cluc164/quad/README.md

# Quadcopter Build

I saw a video on how quadcopters worked and it inspired me to really learn the science behind quadcopters, how they're constructed, and to try to build my own! The first step was to essentially read as much as possible: watching YouTube videos, reading research papers, relearning physics...

I wanted a challenge, but I also didn't want to be completely in over my head. Luckily, people have built quadcopters before and I was able to find a guy on YouTube who had built one and provided both source code and a schematic! But I didn't want to be boring and just yoink someone else's code for a project like this without understanding it... So I yoinked his schematic, bought all the parts, and began learning how to program flight control software. 

## Transmitter

For some reason, I figured that starting with the thing that allowed me to actually control the quadcopter was a good idea! I bought an FS-T6 transmitter/receiver combo, and from reading the manual I knew that controls were linked with certain channels; e.g. the right stick's x-axis (roll) corresponded with channel 1 on the receiver. I connected channels 1-4 to the Arduino's I/O pins 8-11 via jumper cables, and set to work.

At first, I didn't understand how the state of the transmitter was communicated at all, so I just tried to set the pins that I had connected to the receiver to digital input, and from there simply digitalRead() the values; easy, right? Well, not really. 

Turns out we've thought up some really, really clever ways to communicate information. Transmitters and receivers for RC control make use of a concept called Pulse-Width Modulation (PWM) that allows the transmitter to communicate data about its state using digital pulses of a certain duration. Each of these signals is transmitted via a single channel as discussed above. Reading the length of these pulses gives us the information about the position of the control. These will be measured in microseconds, so for example; 1000us pulse length = stick all the way to the left, 1500us = stick in the middle, 2000us = stick right.

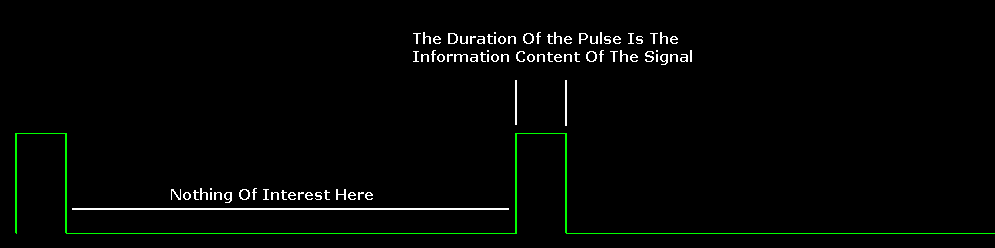
[picture p1: pictures/PulseDuration.PNG]


So, calling digitalRead() on the pin was wrong, and I somehow needed to measure the pulse length of four signals... I googled it and found [this](https://ryanboland.com/blog/reading-rc-receiver-values), which told me I needed to find a way to listen to state changes on each I/O pin corresponding to a channel from the receiver. Arduino provides an `attachInterrupt()` method, which listens to the state of a pin and triggers a callback based on that; however, it's only implemented for pins 2 & 3. I needed four channels, which meant 4 pins. More Google and I found resource (1), which showed me how to interact directly with the Atmega328p microcontroller on the Arduino board.

 



By setting the PCICR (pin change interrupt control register) within the Atmega to 0b00000001, it allows external interrupts on a range of registers (PCINT0-PCINT7). Of interest to us are PCINT0-PCINT3, which are the registers corresponding to digital pins 8-11. To define which pins trigger an interrupt, we set PCMSK0 to 0x0F, which enables interrupts for state changes on registers PCINT0-PCINT3. Now, whenever the state of one of these pins is changed from high to low or vice versa, the microcontroller will trigger a software response called an Interrupt Service Routine (ISR) where I can run logic and do something useful, like read the state of a register! What I have at this point is a program that listens for state changes on I/O pins 8-11 and when that occurs, a function called `ISR(PCINT0_vect) {}` is called.  

We want to measure the time from when the signal goes high to when it goes back low. First, I started with a single channel: when the ISR is triggered, read the least significant bit of PINB (more info in resource (2); address that allows direct read access to PORTB, which is the register corresponding to pin 8). If this bit is 1, then the state is high and we know the state just went from low to high (rising edge) so we can record the current time. Now, we just wait until the state falls from high to low, and record the difference between the time at that point and the time recorded at the rising edge. This gives us the pulse length for a single channel.

Excited that I'd correctly obtained data from the transmitter, I copy and pasted the code and edited it to look at the data from all 4 channels and rather than getting nice, clean numbers between 1000 and 2000, I got this data where each column corresponds to a channel's input. 

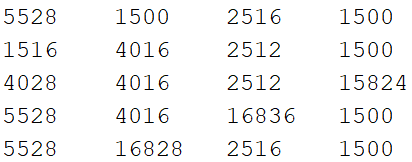
[picture p2: pictures/unstable.png]
 

Looking into this, you can notice that some columns do actually get nice data once and awhile, but it's inconsistent. I realized that in some cases, it's entirely possible that one pin's interrupt could occur during the time in which another pin has already been high or low for a certain amount of time. Blindly recording the time works for a single channel when we can guarantee the ISR is triggered on a rising or falling edge; this will not work when there are 4 pins that can each individually trigger the ISR at different times. Essentially, the time was being measured incorrectly because pin state changes were occurring at different times with no fail-safes to ensure we were properly measuring one pulse or another. To fix this, simply add in a state check that verifies whether or not we have already detected the rising edge for a specific pulse.  This ensures that only the rising/falling edge is detected for each channel, and the pulse lengths are recorded properly. After adding in these checks for each channel, the data columns are much nicer looking, albeit minutely noisy. 

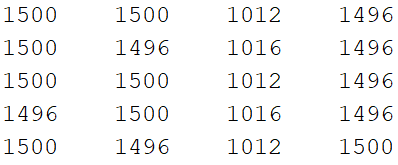
[picture p3: pictures/stable.png]


At this point, I have stable data that corresponds to the position of each control stick on the transmitter. All I will do is absolutely ensure that the values are within a certain range via mapping.

## Motors

For my quadcopter, I bought 1000KV brushless motors with 30A electronic speed controllers (ESCs). With an 11.1V battery, this meant my motors could spin at up to roughly 11,000 RPM... which is pretty fast! The motor speed is controlled by pulses from the ESC, which are then in turn controlled by a PWM signal from an input pin.

There seemed to be a couple ways I could do this; use the provided Servo library and just send it the output signal, or actually create the pulses myself. The first option was easiest just to get it actually working so I did that, and had a spinning motor up and running within about 10 minutes. The problem is that this required me to write to the motors sequentially; I couldn't trigger all 4 motors at exactly the same moment, I'd have to write to one, then the next... That's not exactly desirable, so I started to look into using port manipulation to send all four motor pulses at the same time.

Now that I know how to read/write from registers representing I/O pins, it's much easier to wrap my head around what I needed to do, and I started by drawing a picture. Essentially I needed to reverse what I'd done when reading in the PWM signal from the transmitter: send out a digital signal that's high for a certain duration of time to each pin corresponding to a motor. To accomplish this I only really required three things: a pulse length (which I get from the signal from the transmitter's throttle stick), a start time, and a connection point (I connected a single motor to pin 4, which is PORTD register 4).

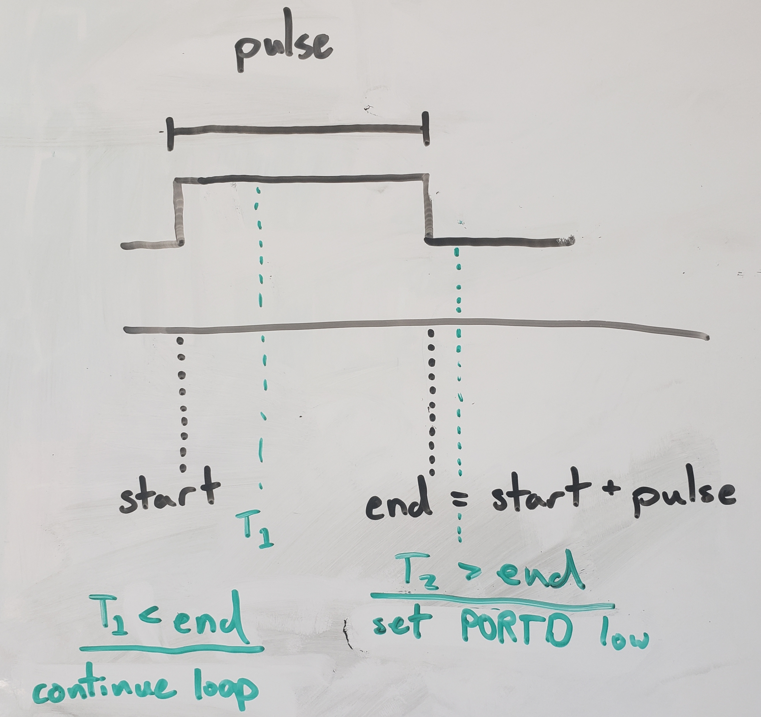
[picture p4: pictures/motor_pulse.jpg]


All I did was set PORTD4 high and then enter into a loop. Inside this loop, I checked the current time against the start time added to the pulse length; if the current time is less than that value, the pulse should remain high. However, as soon as the current time is equal to or greater than the saved end time, we should set the pulse to low, which allows the loop to exit. This is scalable to all four motor outputs, as four if-statements checking time within a loop is not costly at all, and allows us to relay the PWM signal from the transmitter into the motors.

## Frame

So, I forgot to take pictures toward the beginning of the process. But basically, I bought a DJI F450 frame and needed to solder things together and find a way to hold the battery, gyro, controller, and receiver. 

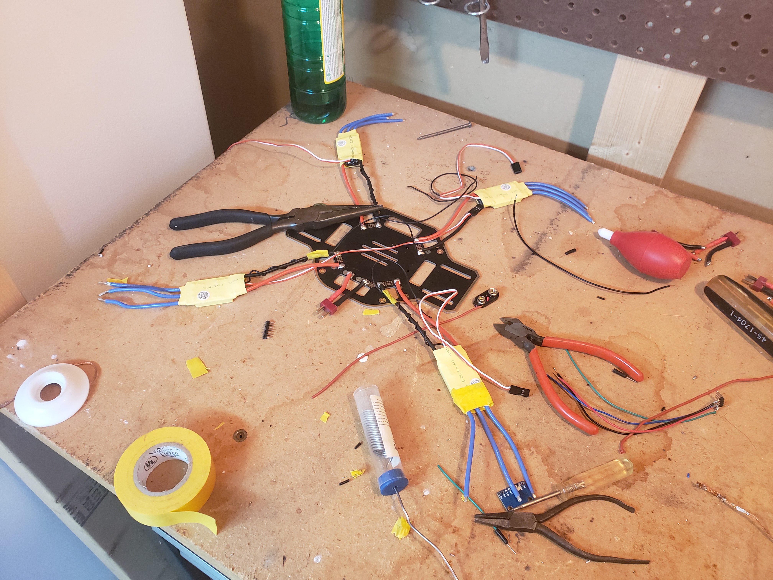
[picture p5: pictures/frame.jpg]


I soldered the ESCs to the frame directly, and also wired the digital ground onto the frame. I also made an LED with a resistor that is plugged into the controller for status indication. Additionally, to power the flight controller and measure the battery voltage, I made a voltage divider and a 2-pin power connection with a diode as follows (don't worry, I isolated everything with electrical tape after I took this picture, heat-shrink is my next purchase):

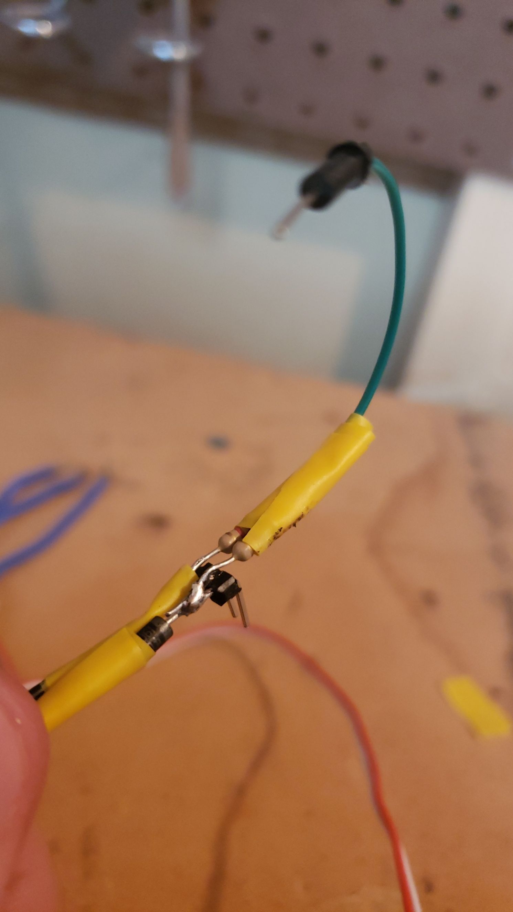
[picture p6: pictures/power.jpg]


After I did this, I attached the ESC and motor connections to bullet connectors, checked all the pins and connections on the frame with a multimeter, and hooked up the Arduino with the LED to the battery connection, and plugged in the battery. The LED started blinking, the ESCs started beeping, and as soon as I turned on the transmitter the LED went solid and I turned up the throttle... all 4 motors worked while attached to the frame! After that, I calibrated the ESCs throttle input range to match the output range of the controller. At this point, I have a frame onto which I can mount my flight controller, motors, and other peripherals, and the ability to throttle the motors up and down via the transmitter.

## Gyroscope + Accelerometer = IMU

The gyroscope/accelerometer I bought (MPU-6050) communicates with a master device (such as a microcontroller) via I2C, a common serial protocol made for communicating with peripherals. Because it can measure angular momentum and acceleration across three axes for each of those respectively, the device provides me with an 6-degree-of-freedom inertial measurement unit (IMU) with which I can keep track of roll and pitch (and yaw, crudely).

Communicating via serial means reading data one bit at a time; connecting the SCL and SDA pins on the MPU to the respective I/O ports on the Arduino allows me to do so via the Arduino Wire library! I2C protocol basically involves talking to a device, telling it where (what registers) you want to interact with it, and then reading or writing from it. Certain registers on the MPU correspond to outputs for its sensors, and the Wire library provides a way of reading a certain number of registers from the requested device (burst read). According to (7) the accelerometer and gyroscope data (16 bits for each axis) are divided up into 8-bit registers starting at 0x3B. The temperature sensor readout is also sandwiched in between the two, so we read 14 registers sequentially so as not to split up readings and save time, but simply ignore the temperature data. Now, we can read the raw data from the accelerometer and gyro's x, y, and z axes respectively!

To really go on from here, I want to describe how I expect my quadcopter to function. When I provide the quad with a 'roll' command, I want it to roll until it reaches a certain angle, then stop. Once I release the stick, it should rotate back to level. In order to do this, I need to keep track of the current heading of the quadcopter and link that directly to motor outputs. Directly linking the motor control to the sticks is a possibility, but it makes it very difficult to fly in a stable manner. So essentially, I want to factor the roll, pitch, and yaw of the quad into the motor outputs received from the transmitter in order to help me fly.

One easy and clean way to keep track of orientation is simply using the accelerometer; we know which direction is down and so we can easily isolate the roll and pitch axes. This is a very crude method for tracking two axes from the output of a 3-axis sensor, but it provides me with a good enough measurement to use for starting up PID motor control (for the moment)

## The Troubles...

So, I had a nice setup for testing the PID algorithm. Motors mounted to a wooden slat with a gyroscope in the middle, and I implemented the proportional response to the error off a zero degree setpoint, with a gain of roughly 1.5. As expected, whenever the roll angle was off by 25 degrees, the control loop added back 25 * 1.5 = 37.5 to the lower motor, and removed 37.5 from the signal to the motor at a higher elevation. Then, I added the integral counter and the derivative response to the movement of the wooden slat on the swivel; but I had a problem. My roll and pitch were calculated using an accelerometer, which meant that any accelerations due to vibrations (such as by motors attached to the same object on which the gyroscope is mounted) would be added into the roll/pitch calculations. As you can see in the next picture, the roll and pitch values when the quad sat on top of a box fan are very, VERY noisy and vary between -3 and -9 degrees. 

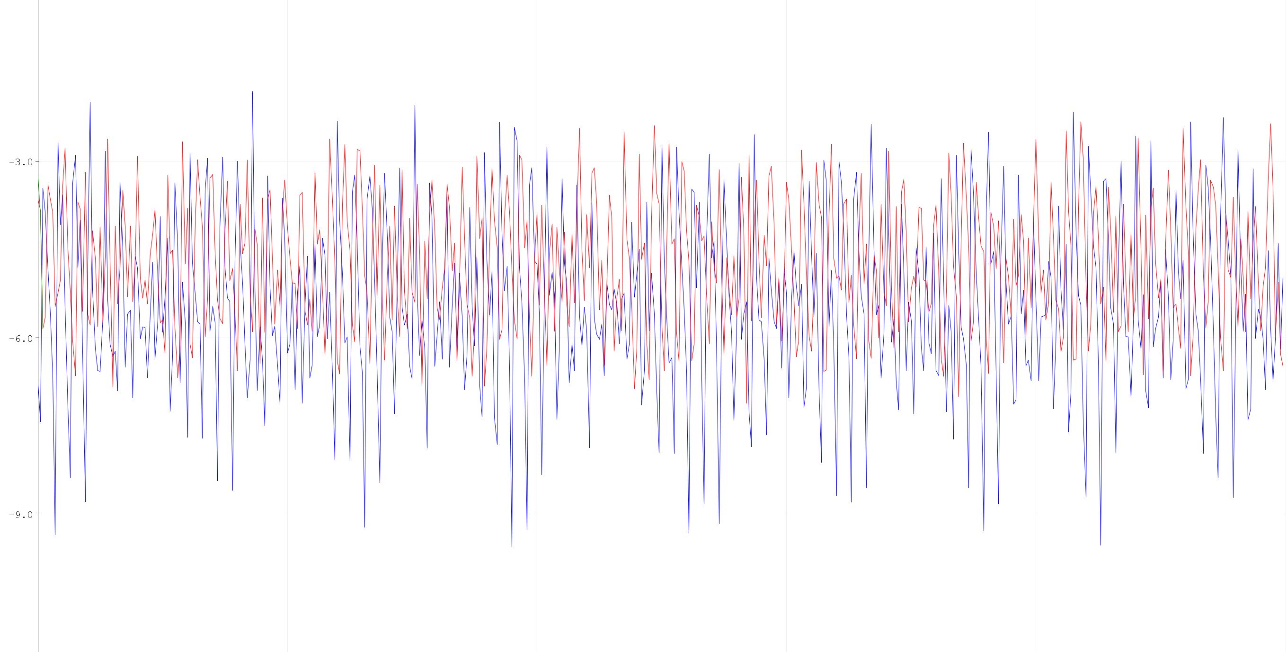
[picture p7: pictures/rollPitchNoisy.JPG]


That means that due to those vibrations, the quad thinks it is oscillating between -3 and -9 degrees, and feeding that error into the PID algorithm. The derivative response is responding directly to the speed of the movement of the roll value. If this value flucatuates in this manner, the quad will spin out of control completely. In order to fix this, I spent time googling and found a few ways of including the gyroscope values along with the accelerometer. A gyroscope is very good at measuring angular momentum in short time frames, but it tends to drift from its true value over time. On the other hand, an accelerometer will be very stable over time, but it's quite sensitive to small fluctuations as we've seen already. Essentially, by combining the two using a complementary filter (the two are combined with a moving average summed to 1). The gyroscope takes precedence over the accelerometer in this, because it is more stable in the short term; we are keeping a counter of how far the quad has travelled using the gyroscopes degrees/second measurement, dividing it by the clock frequency (250 khz) to act as an integrator. Then, this is combined with the roll and pitch derived from the accelerometer using some trig functions I stole from Wikipedia! 

After I combined these two sets of roll and pitch values and placed the quad back on the fan, the roll and pitch values were incredibly more stable! The quad was resting at a slight angle, so the recorded values of -3 and -6 are fairly accurate! Check it out!

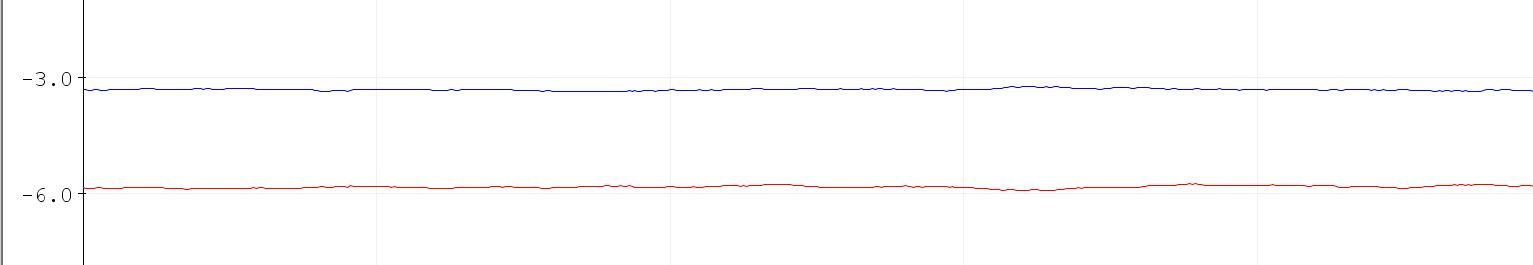
[picture p8: pictures/IMUstabilized.JPG]


So, After that, I was ready to go! Well, no, I accidentally shorted the serial data and clock lines on my Arduino board. I didn't realize it at first, so I figured out how to upload compiled Intel HEX files directly onto the Atmega Microchip's flash memory using a Raspberry Pi tied directly into the in-circuit serial programming pins on the Arduino board. I felt pretty sweet; I had figured out the clock and data lines were bad, I uploaded hex-code onto a chip, I ordered a new Arduino and was ready to go!

I continued to use avrdude to program the new Arduino board I had received and was getting things to work; test programs ran well and I/O was working. However, I still couldn't upload over serial... Remember how I was uploading programs directly into flash? Well, Atmega chips have a bootloader - a program placed in a special part of flash memory - that receives data from the Arduino's serial bus on the USB-B port. I had overwritten it, and so I couldn't upload via serial, and communicating over Serial didn't seem to be working either...

# Resources

(1) [External Interrupts on Arduino](https://sites.google.com/site/qeewiki/books/avr-guide/external-interrupts-on-the-atmega328)

(2) [Atmega328p Documentation](http://ee-classes.usc.edu/ee459/library/documents/Atmel-42735-8-bit-AVR-Microcontroller-ATmega328-328P_Datasheet.pdf)

(3) [Port Information](https://web.ics.purdue.edu/~jricha14/Port_Stuff/)

(4) [FS-T6 Manual](https://fccid.io/N4ZFLYSKYT6/User-Manual/User-manual-1740934.pdf)

(5) [Information about PWM](https://oscarliang.com/pwm-ppm-difference-conversion)

(6) [ESC configuration sheet](https://www.optimusdigital.ro/index.php?controller=attachment&id_attachment=451)

(7) [MPU6050 Register Map](https://invensense.tdk.com/wp-content/uploads/2015/02/MPU-6000-Register-Map1.pdf)
