cluc164/quad/pictures/accelGyroRawDAta.JPG

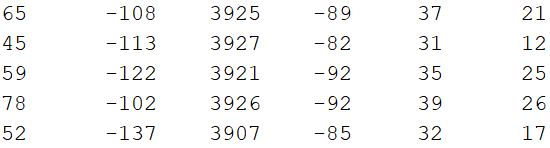
pictures/accelGyroRawDAta.JPG
