cluc164/quad/pictures/gyroscope.JPG

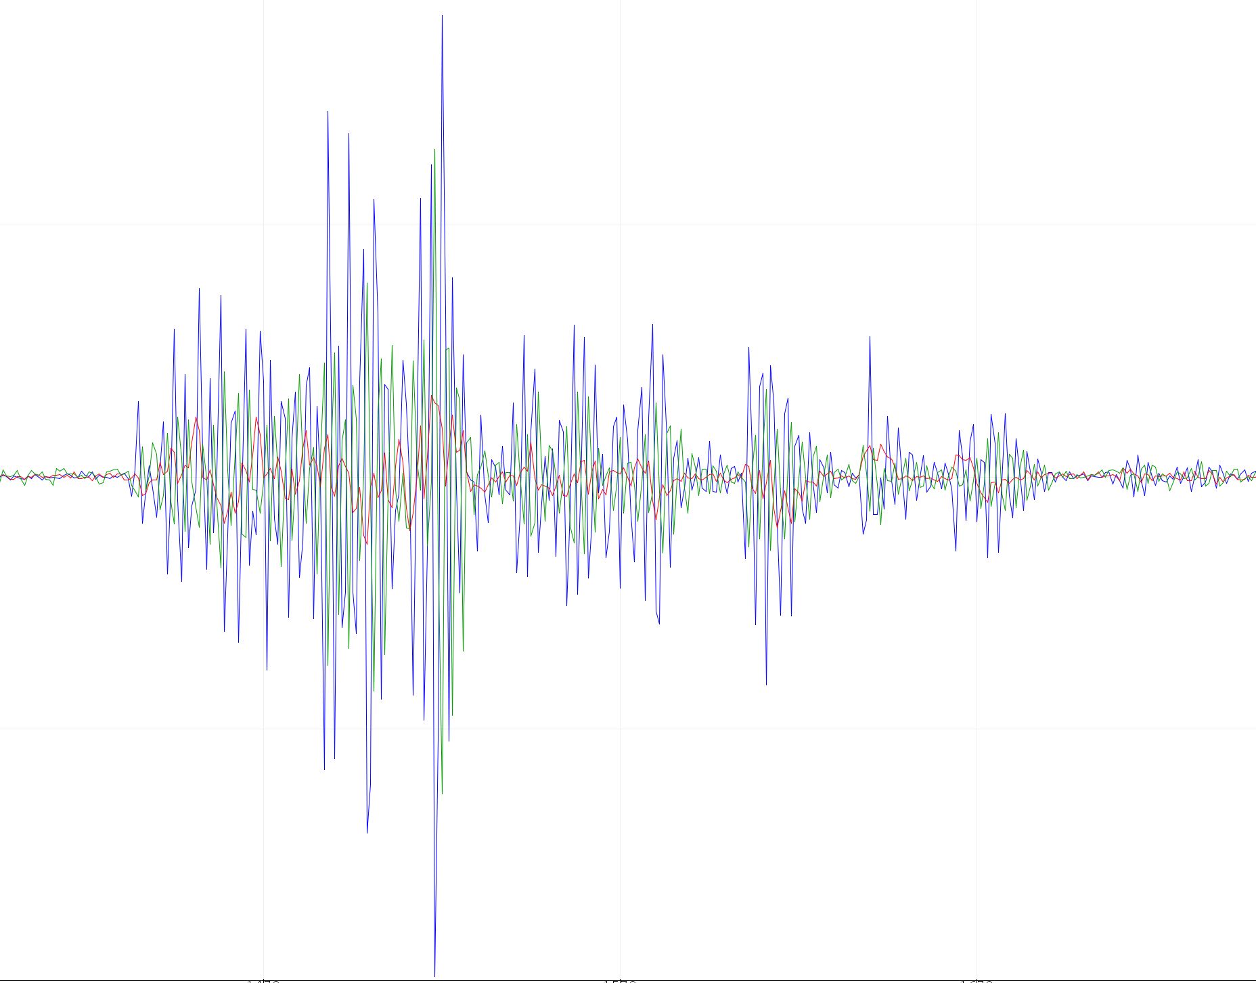
pictures/gyroscope.JPG
