cluc164/quad/IMU/IMU.ino

#include <Wire.h>

const int MPU = 0x68; // address of the MPU-6050 that I2C uses to initiate communication
const int I2C_CLOCK = 250; // I2C clock frequency, in hz

const float ACCEL_SENSITIVITY = 8192.0;
const float GYRO_SENSITIVITY = 65.5;
const int NUM_CALIBRATION_CYCLES = 2000;

int16_t accRaw[3];
int16_t gyroRaw[3];
int temp;
float acc[3];
float gyro[3];
float gyroCal[3];

float roll_acc, pitch_acc, yaw;
float roll, pitch;

unsigned long timer;

void setup() {
  digitalWrite(SDA, 1);
  digitalWrite(SCL, 1);
  DDRB |= 0b00010000; // pins 8-11 set to input, 12 is output
  // Serial.begin(115200);
  for (int i = 0; i < 5; ++i) {
    digitalWrite(12, HIGH);
    delay(200);
    digitalWrite(12, LOW);
    delay(200);
  }
  delay(1000);
  TWBR = 12; // Setting the clock to 250 hz
  Wire.begin();
  Wire.beginTransmission(0x68);
  Wire.write(0x6B);
  Wire.write(0x00);
  Wire.endTransmission(false);
  for (int i = 0; i < 4; ++i) {
    digitalWrite(12, HIGH);
    delay(200);
    digitalWrite(12, LOW);
    delay(200);
  }
  delay(1000);
  // Configure MPU to use +500 deg/seconds for the gyroscope sensitivity and +4g for accelerometer
  Wire.beginTransmission(MPU);
  Wire.write(0x1C);                 
  Wire.write(0b00001000);
  Wire.endTransmission(true);
  for (int i = 0; i < 3; ++i) {
    digitalWrite(12, HIGH);
    delay(200);
    digitalWrite(12, LOW);
    delay(200);
  }
  delay(1000);
  Wire.beginTransmission(MPU);
  Wire.write(0x1B);                   
  Wire.write(0b00001000);               
  Wire.endTransmission(true);
  for (int i = 0; i < 2; ++i) {
    digitalWrite(12, HIGH);
    delay(200);
    digitalWrite(12, LOW);
    delay(200);
  }
  calibrate_gyro();
  delay(1000);
  timer = micros();
  digitalWrite(12, HIGH);
}

void loop() {
  // Get data from the IMU
  read_mpu_data();
  
  // Track how many degrees the craft's roll and pitch has travelled since the last cycle
  // (degrees / seconds) * (1 / (1 / seconds) ) = degrees
  pitch += gyro[1] / I2C_CLOCK;
  roll += gyro[0] / I2C_CLOCK;
  
  // Calculate roll and pitch using data from the accelerometer
  pitch_acc = atan2(-acc[0], sqrt(acc[1]*acc[1] + acc[2]*acc[2])) * 180/M_PI;
  roll_acc = atan2(acc[1], acc[2]) * 180/M_PI;
  
  // Complementary filter combining gyro/accelerometer data
  pitch = pitch * 0.96 + pitch_acc * 0.04;
  roll = roll * 0.96 + roll_acc * 0.04;
  
  // In order for our loop to properly track the travelled roll/pitch angles, we need to ensure that our loop take precisely 4000 microseconds. By doing this, we
  // can use a fixed variable for our time step when using the gyro to find roll/pitch
  while(micros() - timer < 4000); 
  // Serial.print(pitch);
  // Serial.print("\t");
  // Serial.println(roll);
  timer = micros();
}

// Gets data from the MPU6050 and takes it from raw integer form, does the necessary unit transformations, and
// processes it into floats to be used for calculations
void read_mpu_data() {
  Wire.beginTransmission(MPU);
  Wire.write(0x3B); // Start with register 0x3B (accelXOUT_H)
  Wire.endTransmission();
  Wire.requestFrom(MPU, 14); // Request 14 bytes from the MPU, starting at register 0x3B
  while (Wire.available() < 14); 
  accRaw[0] = (int16_t)(Wire.read() << 8 | Wire.read()); 
  accRaw[1] = (int16_t)(Wire.read() << 8 | Wire.read());
  accRaw[2] = (int16_t)(Wire.read() << 8 | Wire.read());
  temp = (Wire.read() << 8 | Wire.read());
  gyroRaw[0] = (int16_t)(Wire.read() << 8 | Wire.read());
  gyroRaw[1] = (int16_t)(Wire.read() << 8 | Wire.read());
  gyroRaw[2] = (int16_t)(Wire.read() << 8 | Wire.read());
  acc[0] = accRaw[0] / ACCEL_SENSITIVITY;
  acc[1] = accRaw[1] / ACCEL_SENSITIVITY;
  acc[2] = accRaw[2] / ACCEL_SENSITIVITY;
  gyro[0] = (gyroRaw[0] / GYRO_SENSITIVITY) - gyroCal[0];
  gyro[1] = (gyroRaw[1] / GYRO_SENSITIVITY) - gyroCal[1];
  gyro[2] = (gyroRaw[2] / GYRO_SENSITIVITY) - gyroCal[2];
}

/**
 * Read in the gyro data 2000 times and take an average to get the error to use as a correction later on
 */
void calibrate_gyro() {
  for (int i = 0; i < NUM_CALIBRATION_CYCLES ; ++i){                  
    read_mpu_data(); 
    gyroCal[0] += gyro[0];
    gyroCal[1] += gyro[1]; 
    gyroCal[2] += gyro[2]; 
    delay(3);                                                          
  }
  gyroCal[0] /= NUM_CALIBRATION_CYCLES;                                                 
  gyroCal[1] /= NUM_CALIBRATION_CYCLES;                                                 
  gyroCal[2] /= NUM_CALIBRATION_CYCLES;
}
