cluc164/quad/(commit log)

2020-07-13 fix ISR logic for reading channels
    Rather than blindly check the time elapsed between interrupts, do so with a purpose: ensure that timer operations are only recorded at the rising or falling edge of the clock
    [transmitter.ino]
2020-07-13 added motor testing
2020-07-14 port manipulation for one motor
2020-07-18 4 motors, IMU started
2020-08-04 pid start
2020-08-11 remove vibration noise from IMU calculation
    [IMU.ino]
